MagmaAI/EE437_FinalProject/EE437_FinalProject/EE437 Hardware Block Diagram.jpg

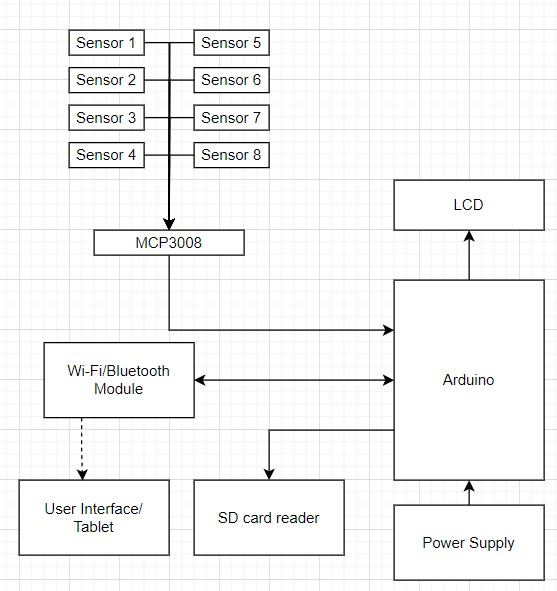
EE437_FinalProject/EE437 Hardware Block Diagram.jpg
