MagmaAI/EE437_FinalProject/EE437_FinalProject/EE437_FlowChart.png

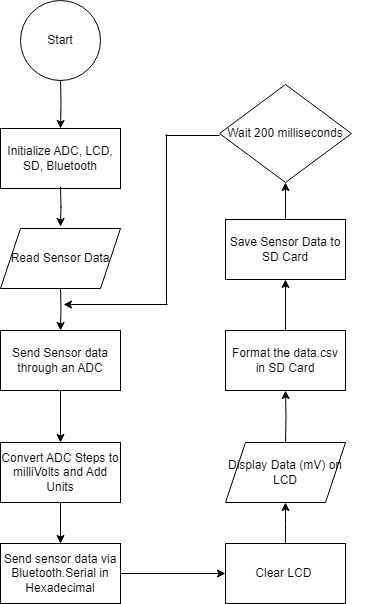
EE437_FinalProject/EE437_FlowChart.png
