MagmaAI/EE437_FinalProject/EE437_FinalProject/Circuit Diagram.sch

## EAGLE design EE437_FinalProject/Circuit Diagram.sch (2023-11-30)

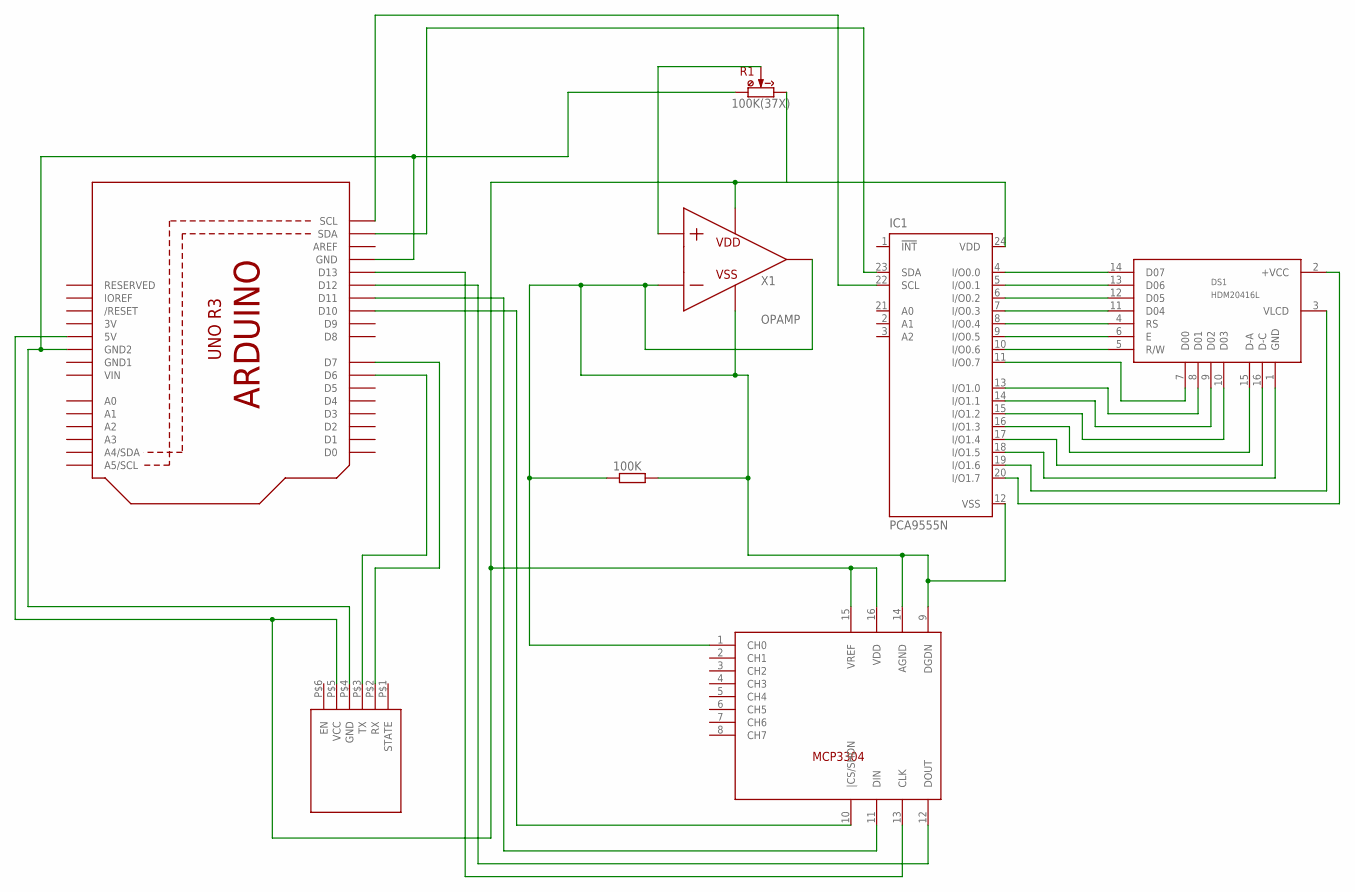
[picture p13: schematic Circuit Diagram.sch]

Parts:
100K: R-EU_0207/5V; 0207/5V
DS1: HDM20416L
IC1: PCA9555N; DIL24-6
R1: 100K(37X); PV37X
U1: ARDUINOR3-DIMENSION; ARDUINOR3
U$1: MCP3304; DIP16
U$2: JY-MCU

Connections:
unnamed: DS1.14 (D07), IC1.4 (I/O0.0)
unnamed: DS1.13 (D06), IC1.5 (I/O0.1)
unnamed: DS1.12 (D05), IC1.6 (I/O0.2)
unnamed: DS1.11 (D04), IC1.7 (I/O0.3)
unnamed: DS1.4 (RS), IC1.8 (I/O0.4)
unnamed: DS1.6 (E), IC1.9 (I/O0.5)
unnamed: DS1.5 (R/W), IC1.10 (I/O0.6)
unnamed: 100K.1, 100K.2, IC1.12 (VSS), U$1.1 (CH0), U$1.9 (DGDN), U$1.14 (AGND)
unnamed: DS1.8 (D01), IC1.13 (I/O1.0)
unnamed: DS1.3 (VLCD), IC1.19 (I/O1.6)
unnamed: U1.D6, U$2.P$3 (TX)
unnamed: U1.D7, U$2.P$2 (RX)
unnamed: IC1.22 (SCL), U1.SCL
unnamed: U1.D10, U$1.10 (|CS/SHDN)
unnamed: R1.1 (CCW), U1.GND, U1.GND2, U$2.P$4 (GND)
unnamed: DS1.7 (D00), IC1.11 (I/O0.7)
unnamed: DS1.2 (+VCC), IC1.20 (I/O1.7)
unnamed: DS1.9 (D02), IC1.14 (I/O1.1)
unnamed: DS1.10 (D03), IC1.15 (I/O1.2)
unnamed: IC1.23 (SDA), U1.SDA
unnamed: DS1.15 (D-A), IC1.16 (I/O1.3)
unnamed: DS1.16 (D-C), IC1.17 (I/O1.4)
unnamed: DS1.1 (GND), IC1.18 (I/O1.5)
unnamed: IC1.24 (VDD), R1.3 (CW), U1.5V, U$1.15 (VREF), U$1.16 (VDD), U$2.P$5 (VCC)
unnamed: U1.D11, U$1.11 (DIN)
unnamed: U1.D12, U$1.12 (DOUT)
unnamed: U1.D13, U$1.13 (CLK)
